gingerskull/Push-Pull-Encoder/docs/through-hole-buttons.md

# PP Stack assembly instructions · Through-hole buttons

These are the assembly instructions for the build with through-hole push buttons. Only the two buttons differ from the [SMD-button build](smd-buttons.md), which is 5 mm shorter. There's also a [printable PDF](../assembly-instructions-through-hole-buttons.pdf) (3 pages). Shop links for every part are in the [parts table](../README.md#parts-and-where-to-buy), and the board order settings are under [Ordering the PCB](../README.md#ordering-the-pcb).

[The parts](#the-parts) · [A · Bottom board](#a--bottom-board) · [B · Top board](#b--top-board) · [C · Assembly](#c--assembly)

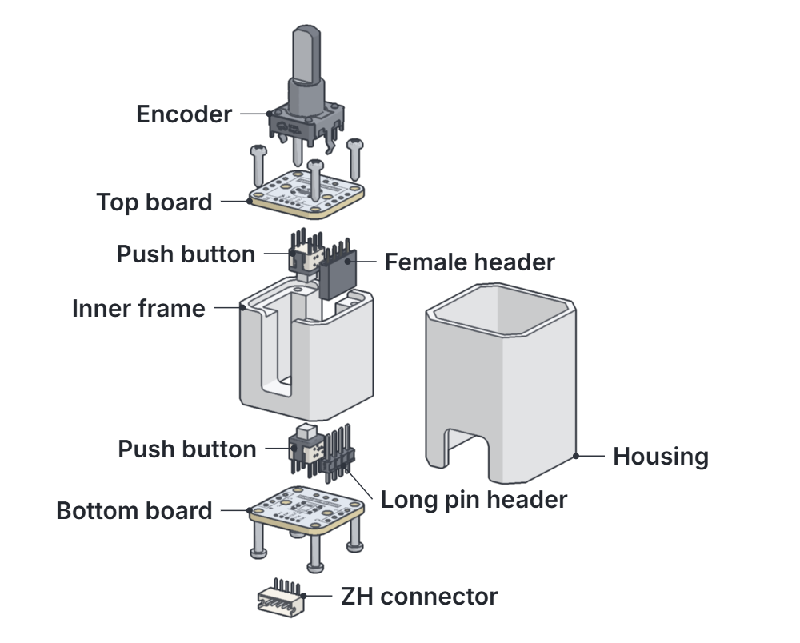
[picture p18: docs/img/through-hole/parts.png]
Exploded view of all parts
<picture><source media="(prefers-color-scheme: dark)" srcset="img/through-hole/parts-dark.png"></picture>

### The parts

| Qty | Part |
|--:|:---|
| 2 | PCB |
| 1 | EC12E rotary encoder |
| 2 | Push button, SAMZO 2010751102 |
| 1 | Female header, 4 pin, 2.54 mm |
| 1 | Long pin header, 4 pin, 21 mm |
| 1 | ZH1.5 connector, 5 pin |
| 8 | M2 self-tapping screw |
| 1 | Inner frame + housing, printed ([STEP](../CAD/printed/PP-Stack-frame-housing-through-hole-buttons.step)) |

You'll also need a soldering iron, flush cutters and a small screwdriver.

> [!IMPORTANT]
> The frame slides up and down inside the housing, so print both accurately. They need only a minimal gap: enough for smooth push and pull, not so much that the knob wobbles. Test-fit the frame in the housing before you assemble anything.

<br clear="right"><br>

---

## A · Bottom board

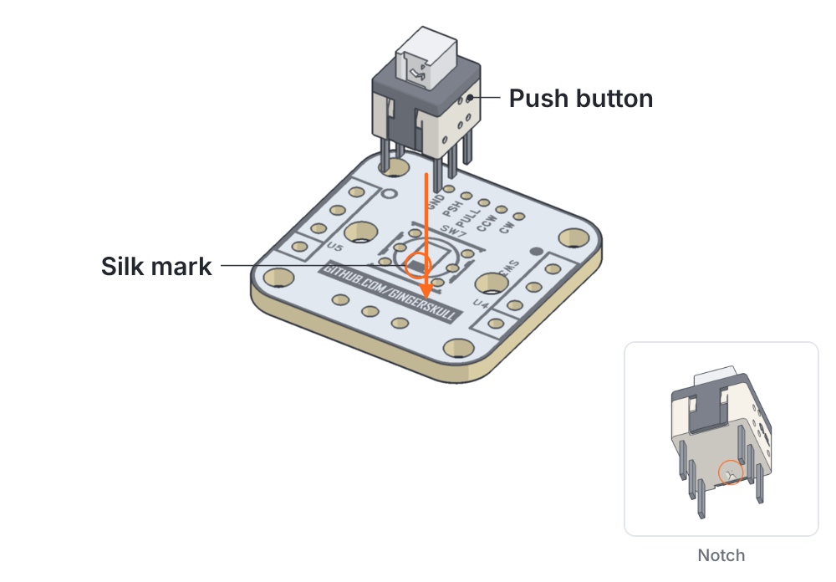
[picture p19: docs/img/through-hole/step-01.png]
Step 1
<picture><source media="(prefers-color-scheme: dark)" srcset="img/through-hole/step-01-dark.png"></picture>

### 1 · Push button

<kbd>Button side</kbd>

Fit SW7 with the notch on its underside **opposite** the filled mark in the SW7 outline.

> [!WARNING]
> Fitted the other way round, the switch works as normally closed.

> [!TIP]
> Trim the legs after soldering.

<br clear="right"><br>

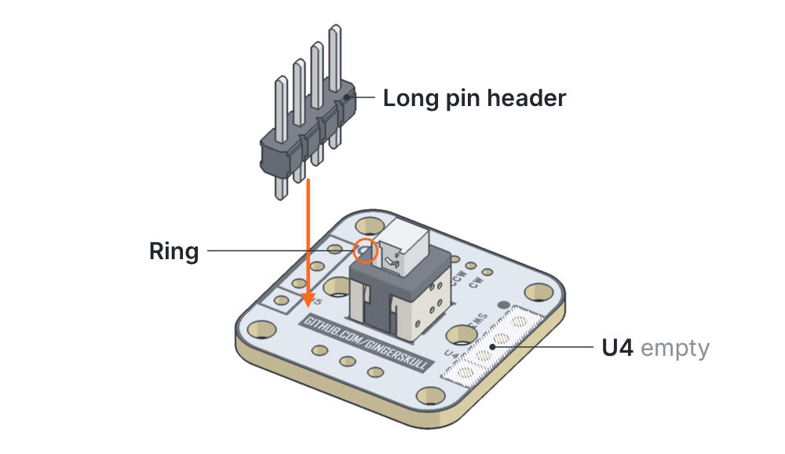
[picture p20: docs/img/through-hole/step-02.png]
Step 2
<picture><source media="(prefers-color-scheme: dark)" srcset="img/through-hole/step-02-dark.png"></picture>

### 2 · Long pin header

<kbd>U5</kbd>

Long pin header into **U5**, next to the ring. U4 stays empty on this board.

> [!TIP]
> Keep it square to the board, since these pins go into the top board's female header later.

<br clear="right"><br>

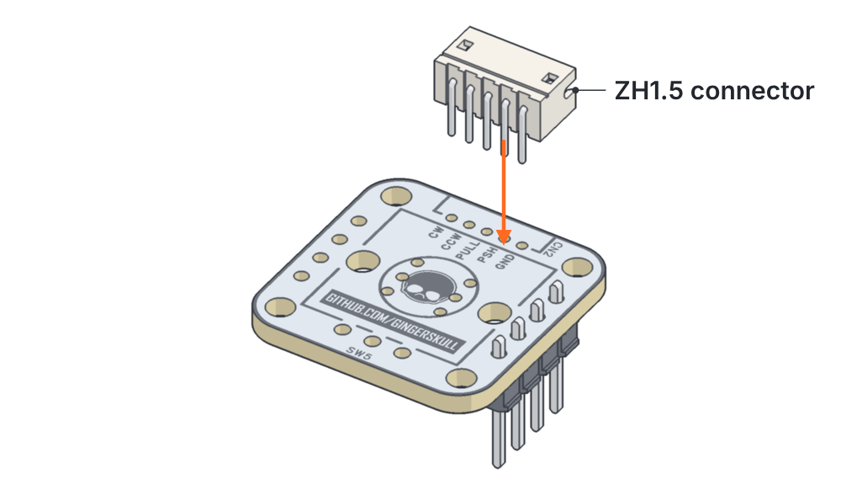
[picture p21: docs/img/through-hole/step-03.png]
Step 3
<picture><source media="(prefers-color-scheme: dark)" srcset="img/through-hole/step-03-dark.png"></picture>

### 3 · ZH connector

<kbd>Flip</kbd>

Flip the board. Fit CN2 with the opening facing the board edge.

<br clear="right"><br>

---

## B · Top board

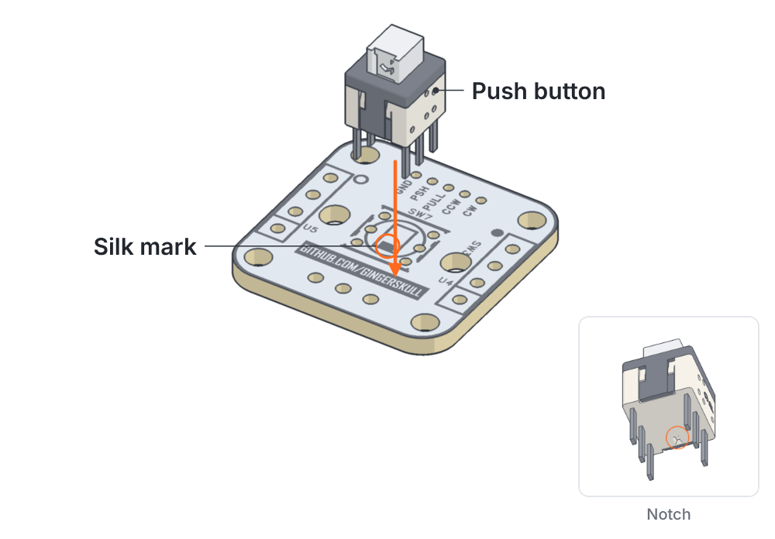
[picture p22: docs/img/through-hole/step-04.png]
Step 4
<picture><source media="(prefers-color-scheme: dark)" srcset="img/through-hole/step-04-dark.png"></picture>

### 4 · Push button

<kbd>Button side</kbd>

Same as step 1: notch opposite the silk mark.

> [!IMPORTANT]
> Trim the legs **flush**. The encoder sits right over them.

<br clear="right"><br>

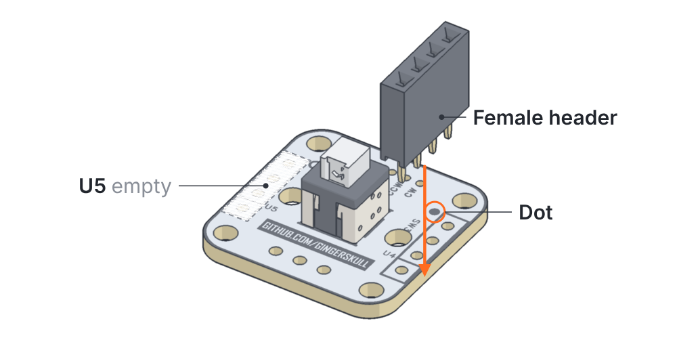
[picture p23: docs/img/through-hole/step-05.png]
Step 5
<picture><source media="(prefers-color-scheme: dark)" srcset="img/through-hole/step-05-dark.png"></picture>

### 5 · Female header

<kbd>U4</kbd>

Female header into **U4**, next to the dot. U5 stays empty on this board.

> [!NOTE]
> When the boards stack, the dot sits over the ring.

<br clear="right"><br>

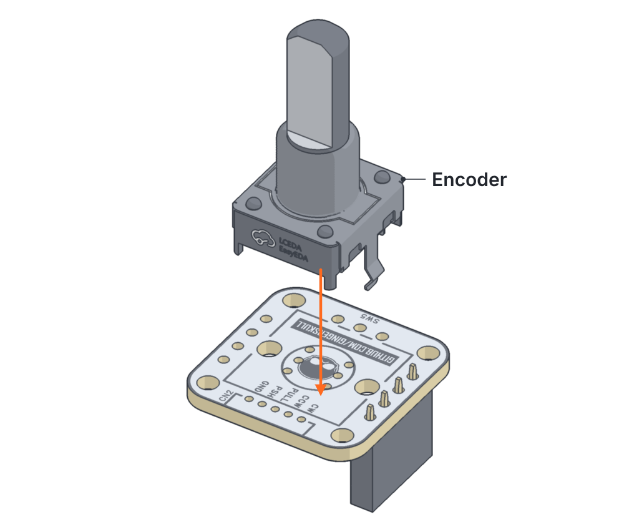
[picture p24: docs/img/through-hole/step-06.png]
Step 6
<picture><source media="(prefers-color-scheme: dark)" srcset="img/through-hole/step-06-dark.png"></picture>

### 6 · Encoder

<kbd>Flip</kbd>

Flip the board and fit the encoder.

> [!TIP]
> Solder the mounting tabs too. They carry the push and pull load.

<br clear="right"><br>

---

## C · Assembly

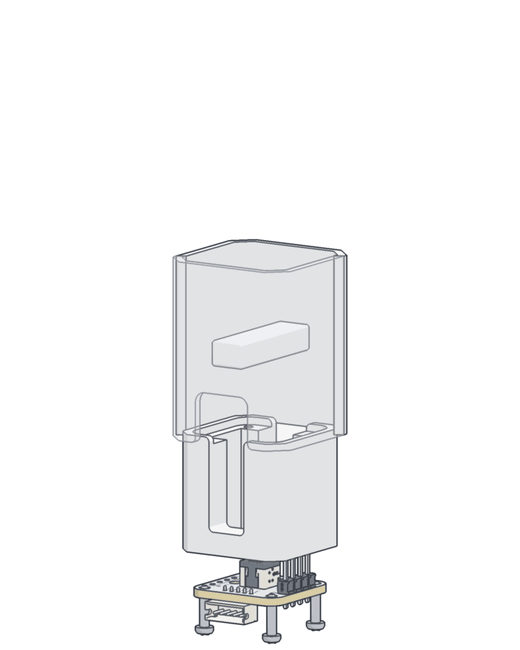
[picture p25: docs/img/through-hole/asm.gif]
Assembly sequence, steps 7 to 10
<p align="center"><picture><source media="(prefers-color-scheme: dark)" srcset="img/through-hole/asm-dark.gif"></picture></p>

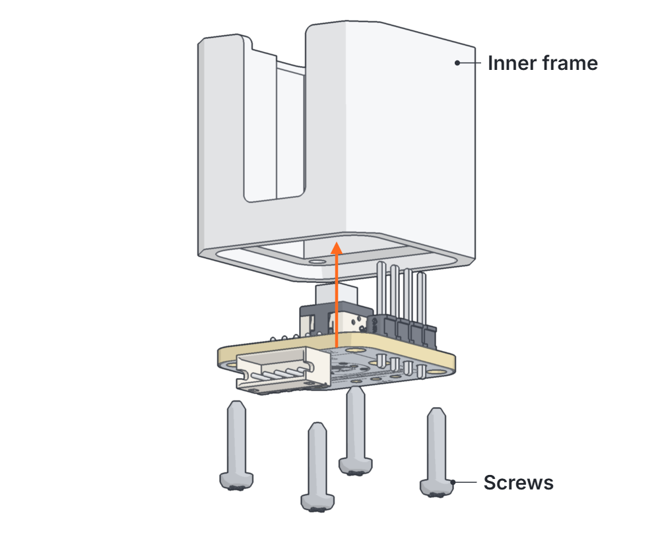
[picture p26: docs/img/through-hole/step-07.png]
Step 7
<picture><source media="(prefers-color-scheme: dark)" srcset="img/through-hole/step-07-dark.png"></picture>

### 7 · Bottom board onto the frame

<kbd>4 × M2</kbd>

Button side into the frame, then four self-tapping screws.

> [!CAUTION]
> Tighten them only until snug. They cut their own threads in the plastic.

<br clear="right"><br>

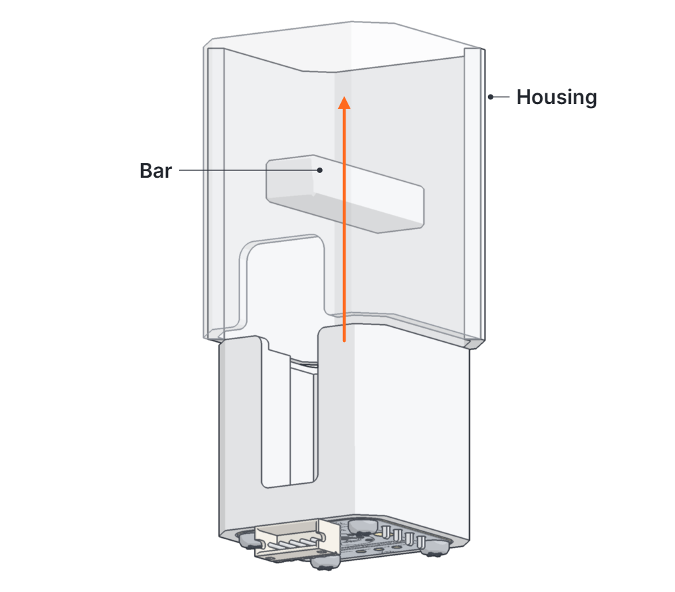
[picture p27: docs/img/through-hole/step-08.png]
Step 8
<picture><source media="(prefers-color-scheme: dark)" srcset="img/through-hole/step-08-dark.png"></picture>

### 8 · Into the housing

<kbd>From below</kbd>

Slide the frame up into the housing. The slots pass over the bar and the connector lines up with the cutout.

> [!NOTE]
> This puts the bar between the two push buttons.

<br clear="right"><br>

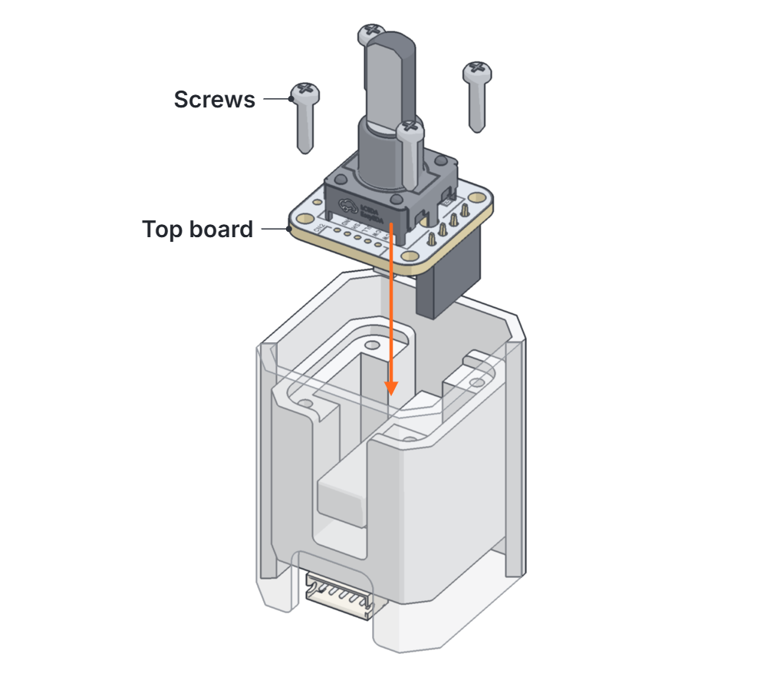
[picture p28: docs/img/through-hole/step-09.png]
Step 9
<picture><source media="(prefers-color-scheme: dark)" srcset="img/through-hole/step-09-dark.png"></picture>

### 9 · Top board

<kbd>4 × M2</kbd>

Lower the female header onto the long pins, dot over the ring, and screw the board down.

> [!TIP]
> Check the pins line up before you push down.

<br clear="right"><br>

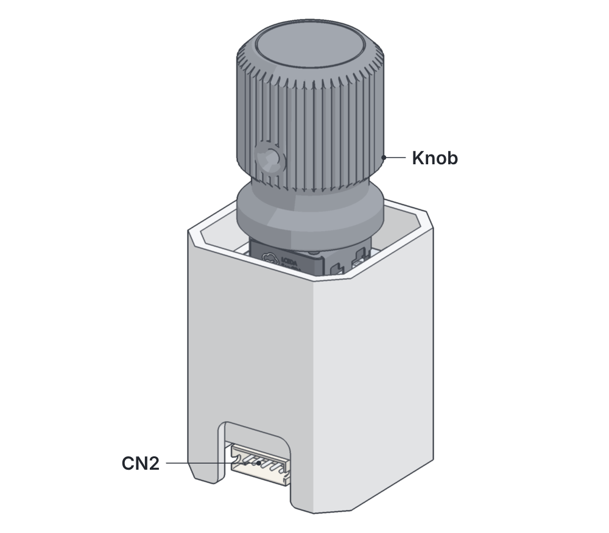
[picture p29: docs/img/through-hole/step-10.png]
Step 10
<picture><source media="(prefers-color-scheme: dark)" srcset="img/through-hole/step-10-dark.png"></picture>

### 10 · Done

Fit the knob and plug in the cable.

| CN2 pin | Signal |
|:---:|:---|
| 1 | GND |
| 2 | PULL |
| 3 | PUSH |
| 4 | CCW (A) |
| 5 | CW (B) |

<br clear="right"><br>

[← Back to the overview](../README.md)
