gingerskull/Push-Pull-Encoder/docs/img/flip-dark.gif

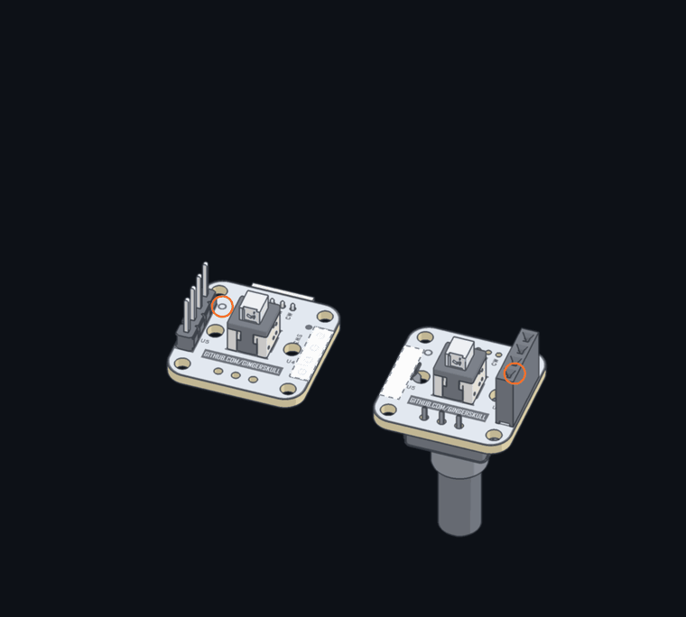
docs/img/flip-dark.gif
