gingerskull/Push-Pull-Encoder/docs/img/hero-dark.gif

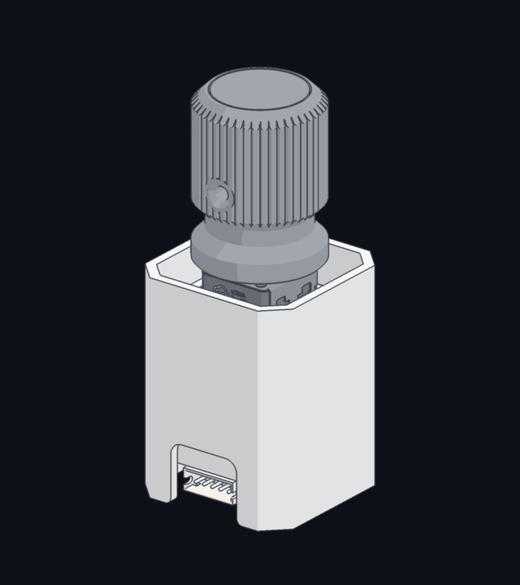
docs/img/hero-dark.gif
