gingerskull/Push-Pull-Encoder/docs/img/smd/asm-dark.gif

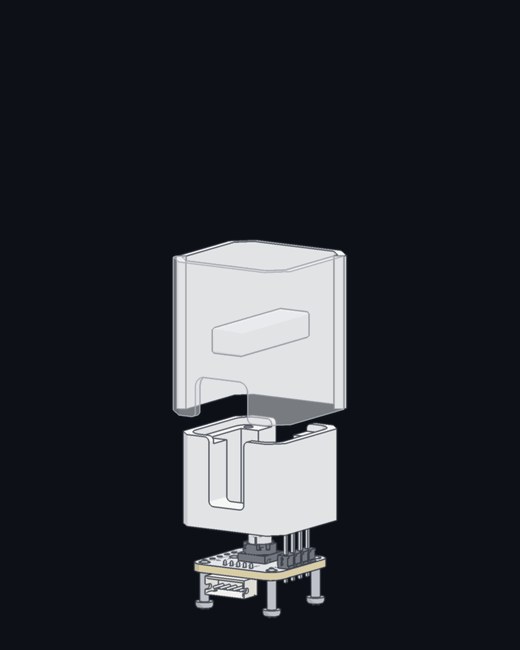
docs/img/smd/asm-dark.gif
