gingerskull/Push-Pull-Encoder/docs/img/smd/how-it-works-dark.png

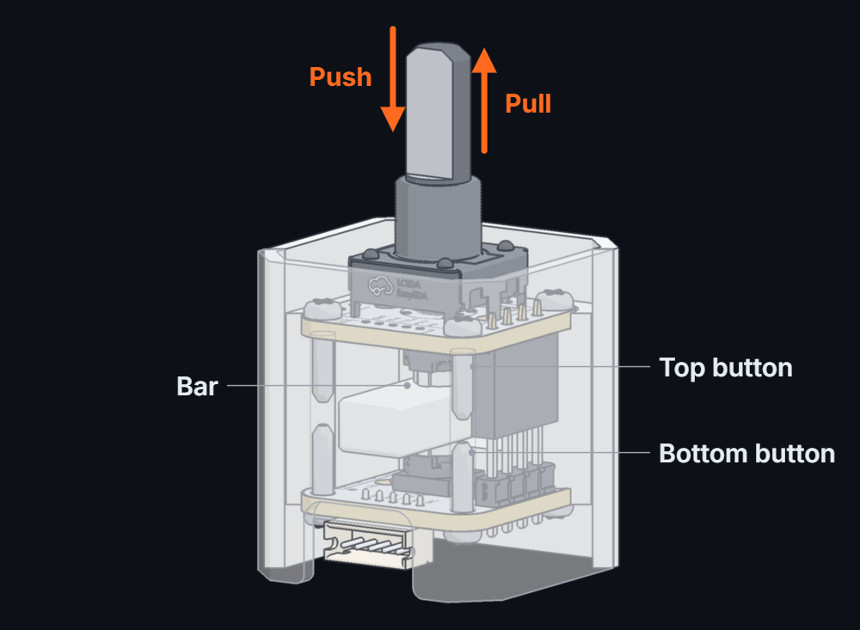
docs/img/smd/how-it-works-dark.png
