gingerskull/Push-Pull-Encoder/docs/img/smd/parts-dark.png

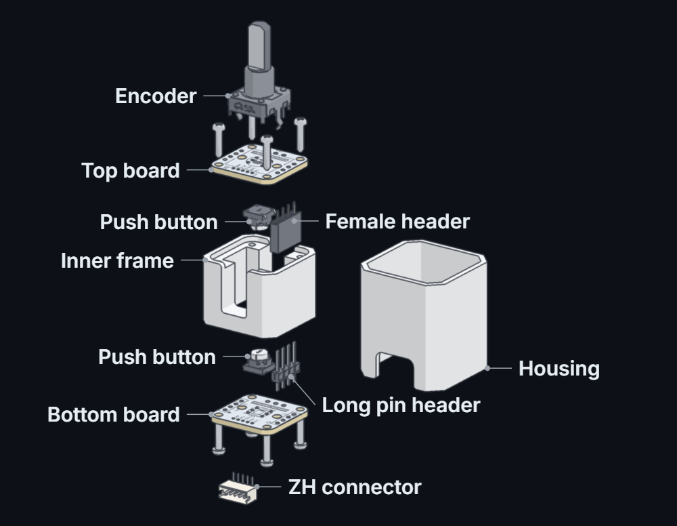
docs/img/smd/parts-dark.png
