gingerskull/Push-Pull-Encoder/CAD/assembly-example/PP-Stack-assembly-example-SMD-buttons.step

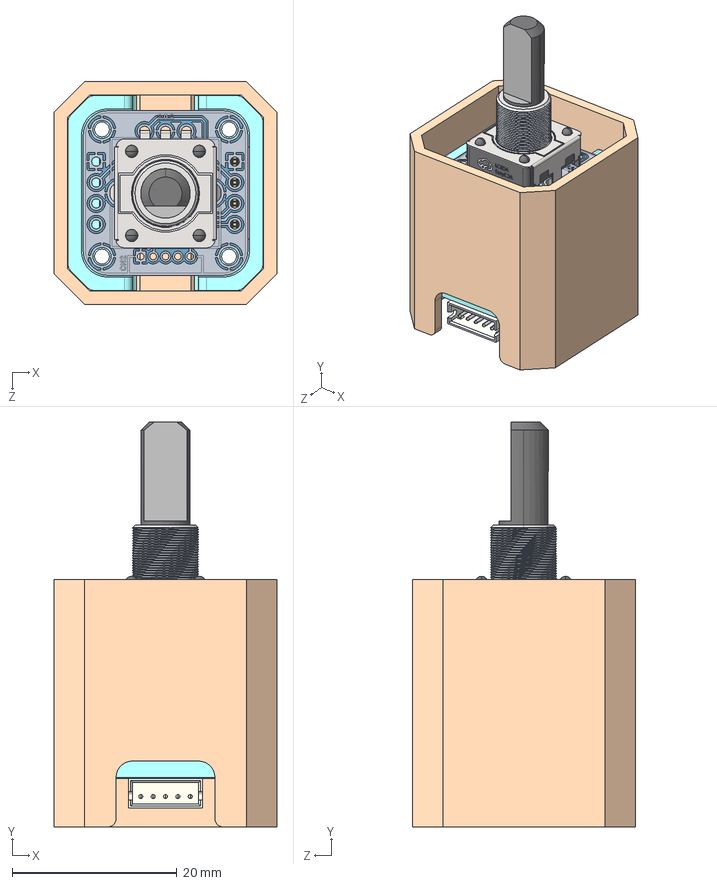
[picture p35: CAD file, 2026-11-04]
CAD/assembly-example/PP-Stack-assembly-example-SMD-buttons.step
27.0 x 49.1 x 27.0 mm
HDR-TH_4P-P2.54-V-F~HDR-TH_4P-P2.54-V-F~UFYu
KEY-SMD_4P-L6.1-W6.0-P4.50-LS7.4~KEY-SMD_4P-L6.1-W6.0-P4.50-LS7.4~UFYu x 2
SW-TH_EC12E2420801~SW-TH_EC12E2420801-L13.2-W12.4-H25.0-P2.5-LS14.0~UFYu
Board~UFYu x 2
TopCopper~UFYu x 2
BottomCopper~UFYu x 2
TopSilkscreen~UFYu x 2
BottomSilkscreen~UFYu x 2
HDR-TH_4P-P2.54-V-M~HDR-TH_4P-P2.54-M-LI-1X4P~UFYu
CONN-TH_5P-P1.50_HCTL_C-ZH1.5-5AW~CONN-TH_5P-P1.50_HCTL_C-ZH1.5-5AW~UFYu
PP Stack V2 - Housing Complete 15mm
