gingerskull/Push-Pull-Encoder/CAD/printed/PP-Stack-frame-housing-SMD-buttons.step

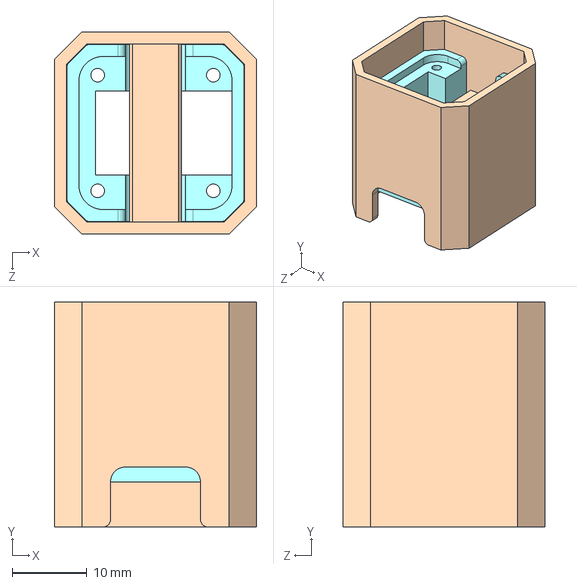
[picture p37: CAD file, 2026-11-04]
CAD/printed/PP-Stack-frame-housing-SMD-buttons.step
27.0 x 30.0 x 27.0 mm
