gingerskull/Push-Pull-Encoder/CAD/printed/PP-Stack-frame-housing-through-hole-buttons.step

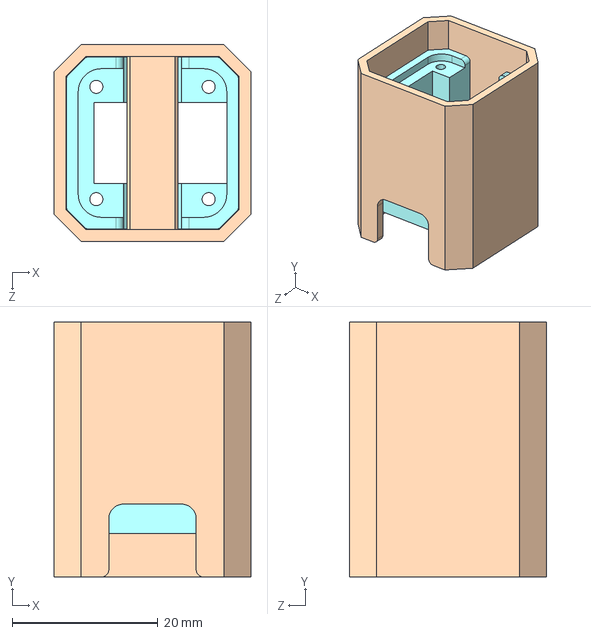
[picture p38: CAD file, 2026-11-04]
CAD/printed/PP-Stack-frame-housing-through-hole-buttons.step
27.0 x 35.0 x 27.0 mm
