gingerskull/Push-Pull-Encoder/CAD/printed/PP-Stack-knob-v3.step

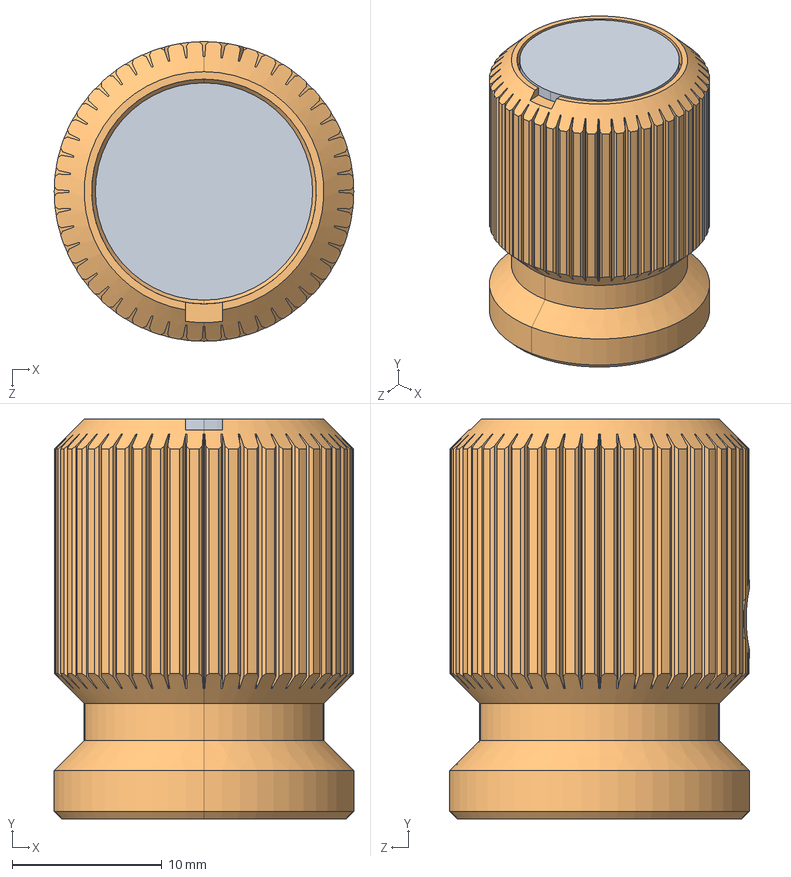
[picture p39: CAD file, 2026-11-04]
CAD/printed/PP-Stack-knob-v3.step
20.0 x 26.7 x 20.0 mm
