gingerskull/Push-Pull-Encoder/assembly-instructions-SMD-buttons.pdf

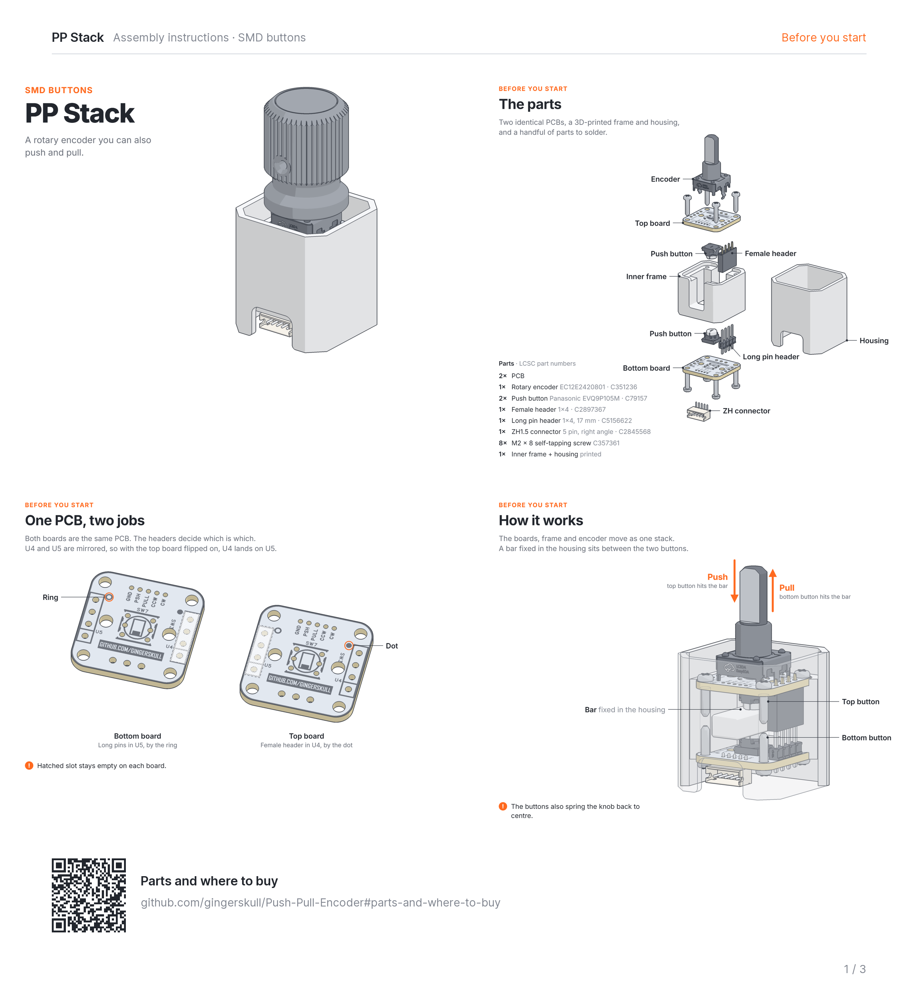
[picture p48: page 1]
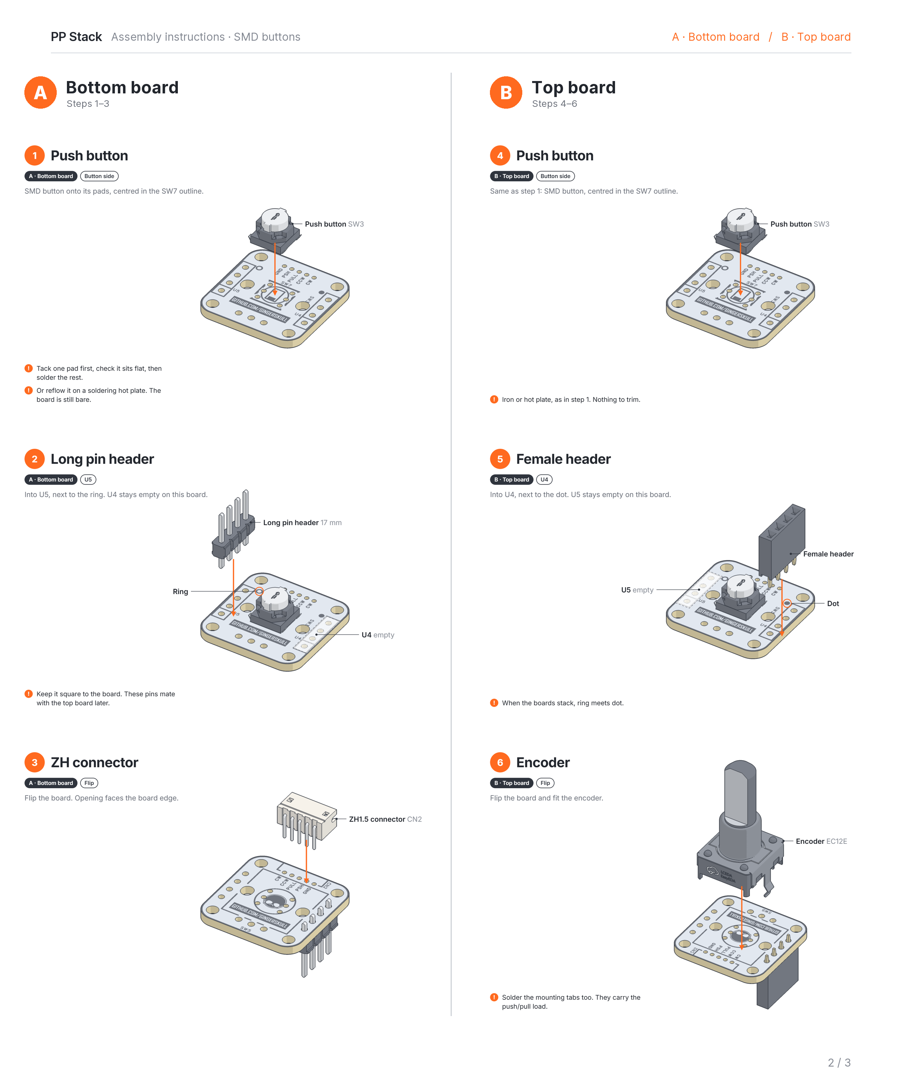
[picture p49: page 2]
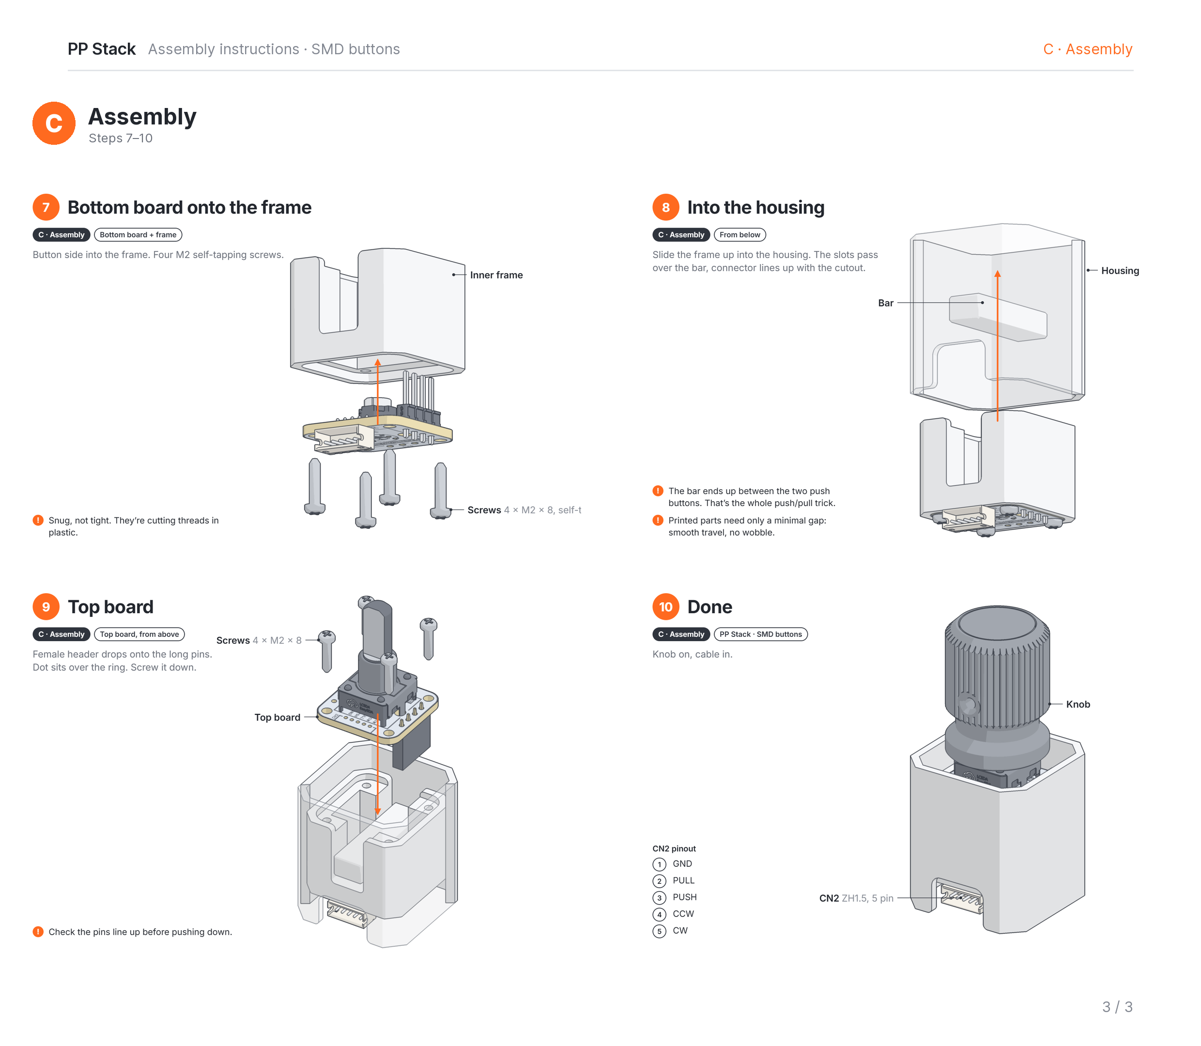
[picture p50: page 3]
