gingerskull/Push-Pull-Encoder/assembly-instructions-through-hole-buttons.pdf

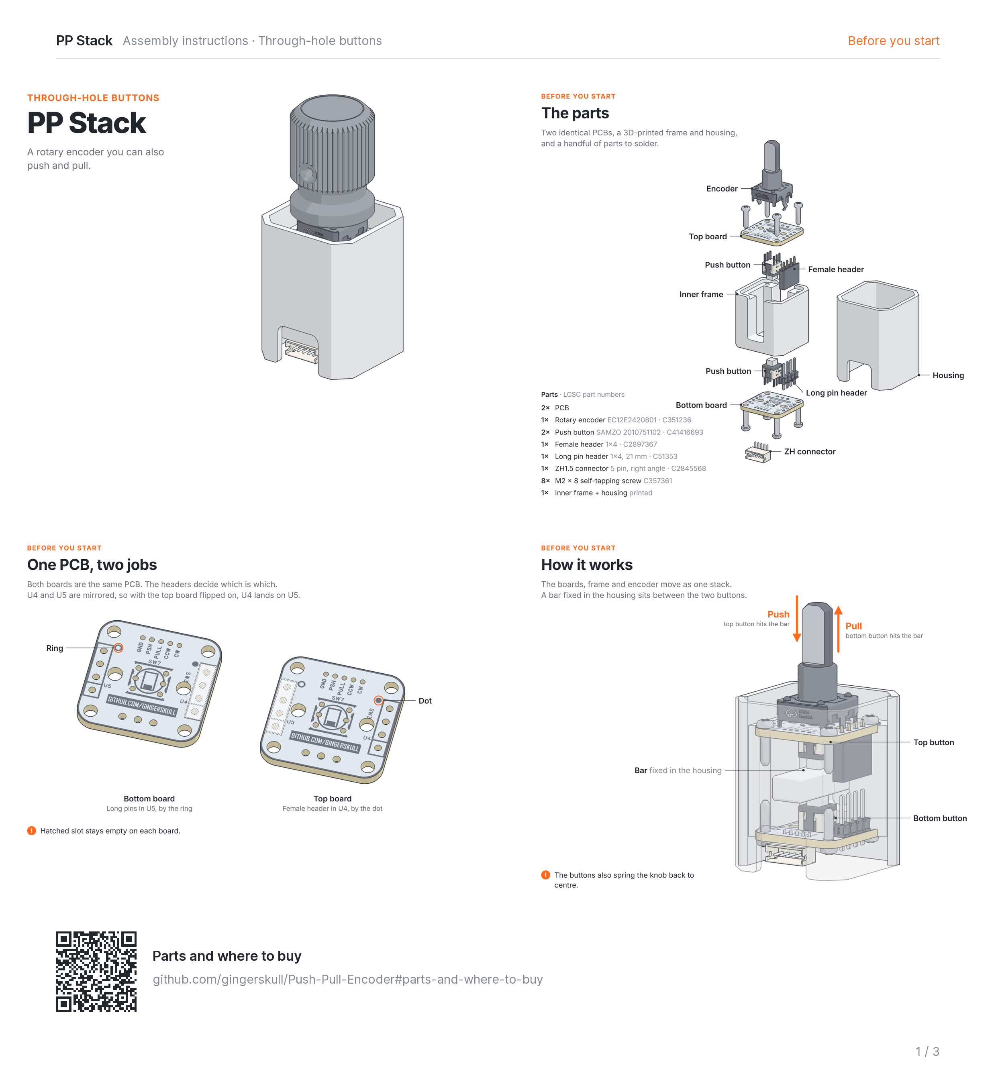
[picture p51: page 1]
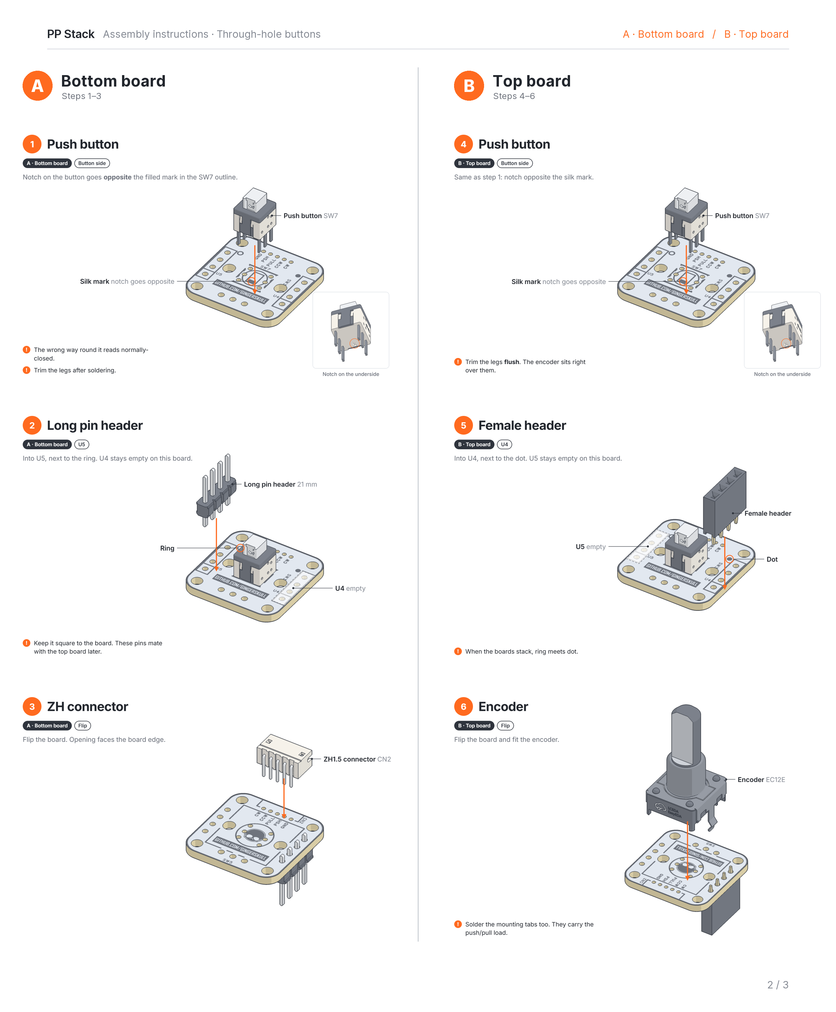
[picture p52: page 2]
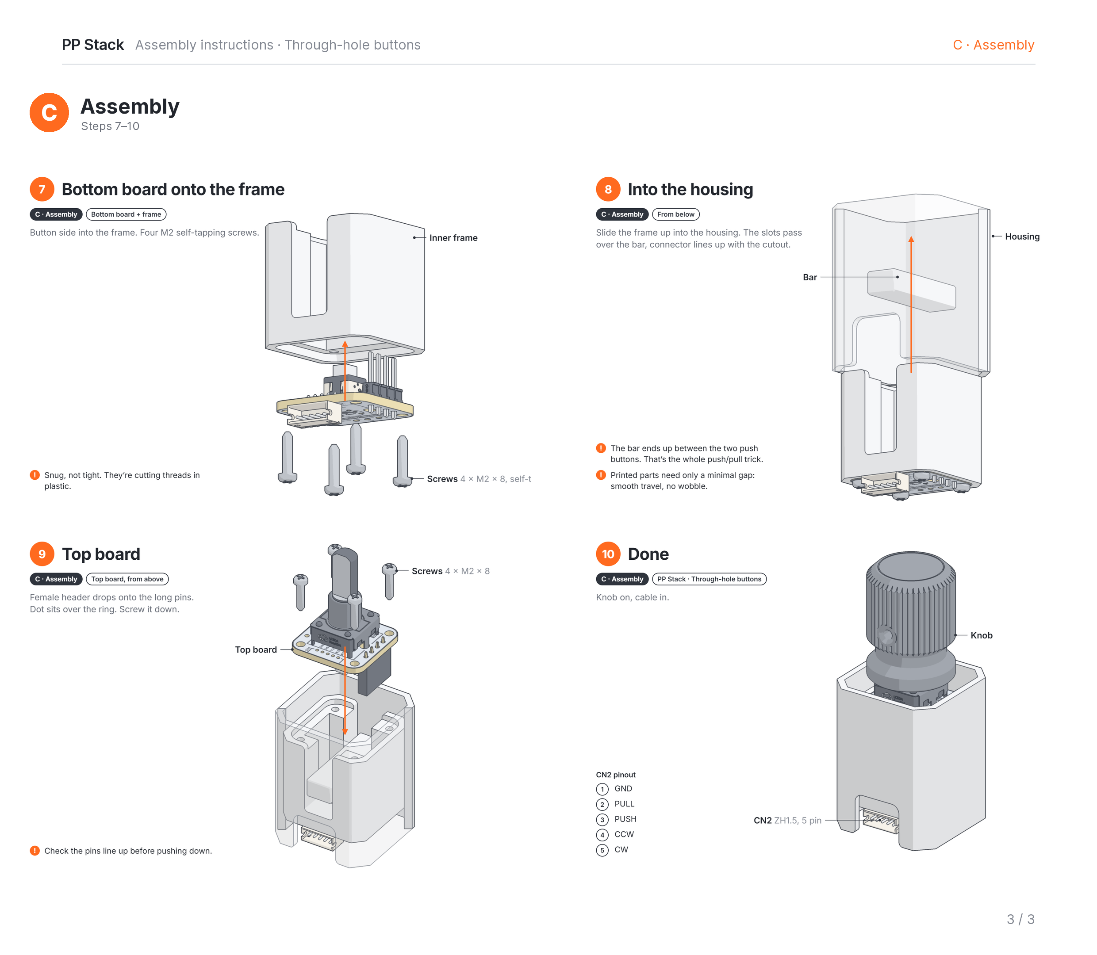
[picture p53: page 3]
