gingerskull/Push-Pull-Encoder/docs/img/build-through-hole-dark.png

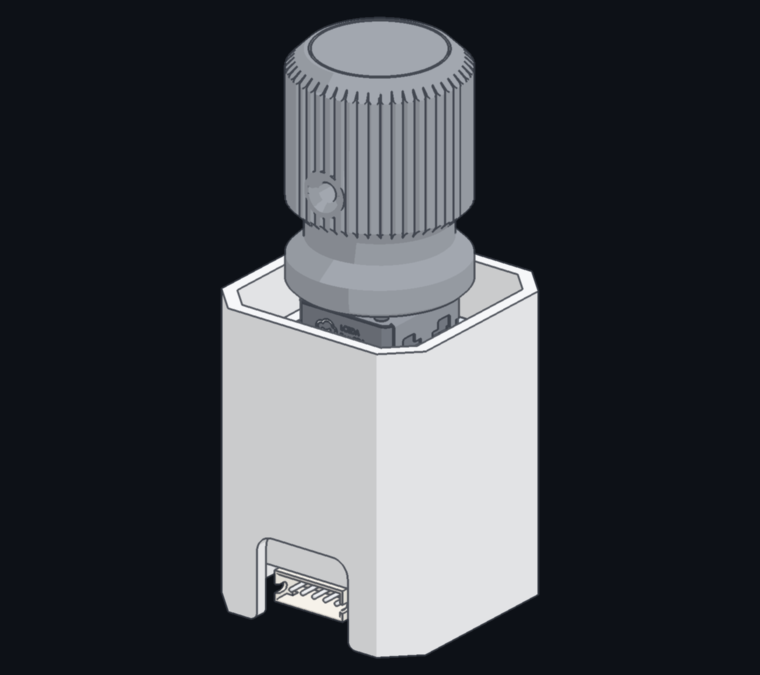
docs/img/build-through-hole-dark.png
