gingerskull/Push-Pull-Encoder/docs/img/smd/step-01-dark.png

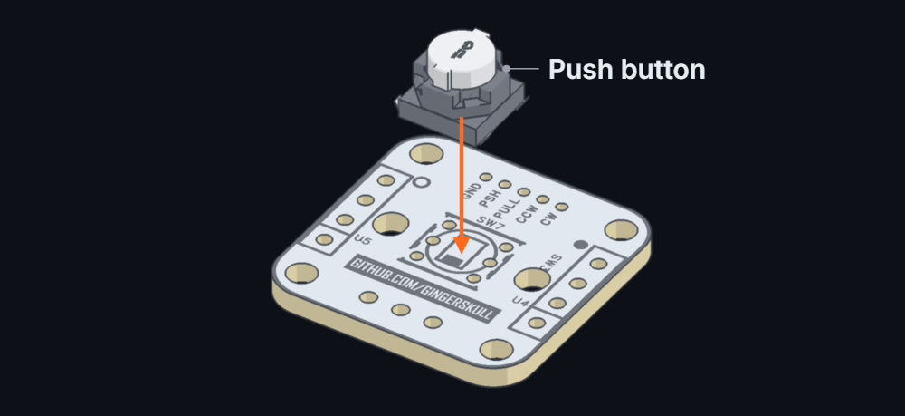
docs/img/smd/step-01-dark.png
