gingerskull/Push-Pull-Encoder/docs/img/smd/step-02-dark.png

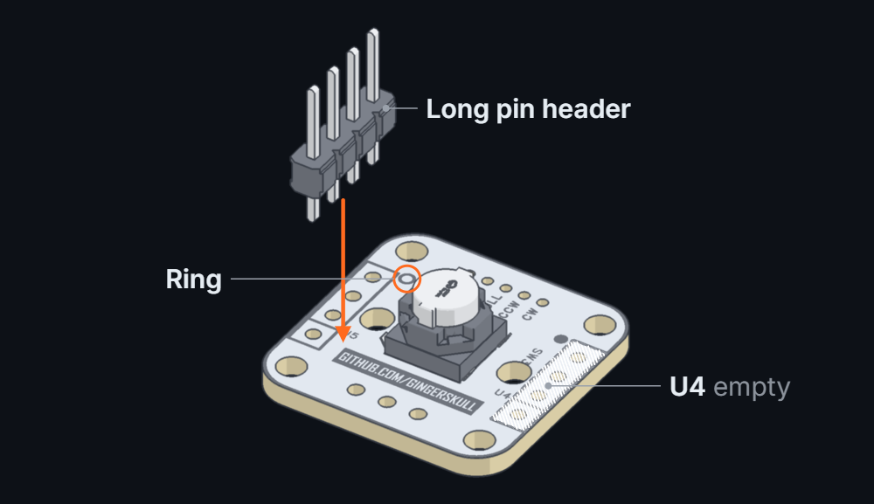
docs/img/smd/step-02-dark.png
