gingerskull/Push-Pull-Encoder/docs/img/smd/step-03-dark.png

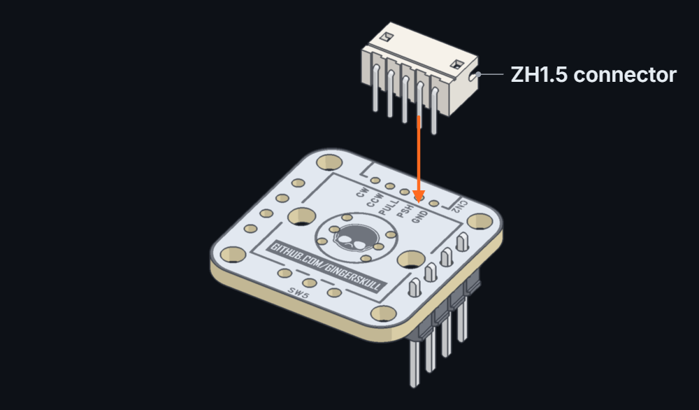
docs/img/smd/step-03-dark.png
