gingerskull/Push-Pull-Encoder/docs/img/smd/step-05-dark.png

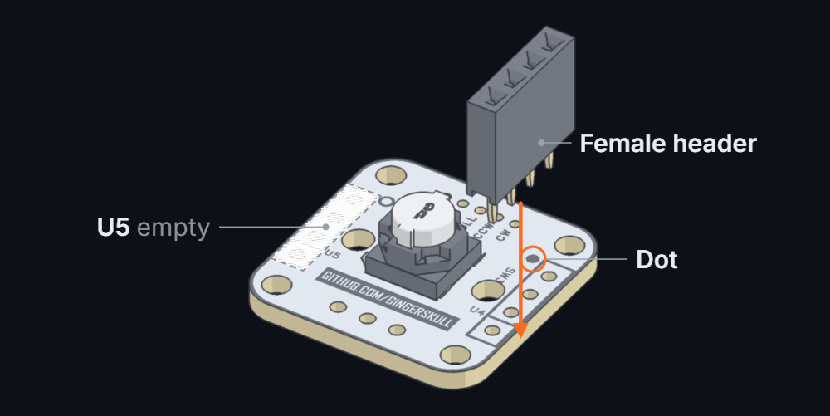
docs/img/smd/step-05-dark.png
