gingerskull/Push-Pull-Encoder/docs/img/smd/step-06-dark.png

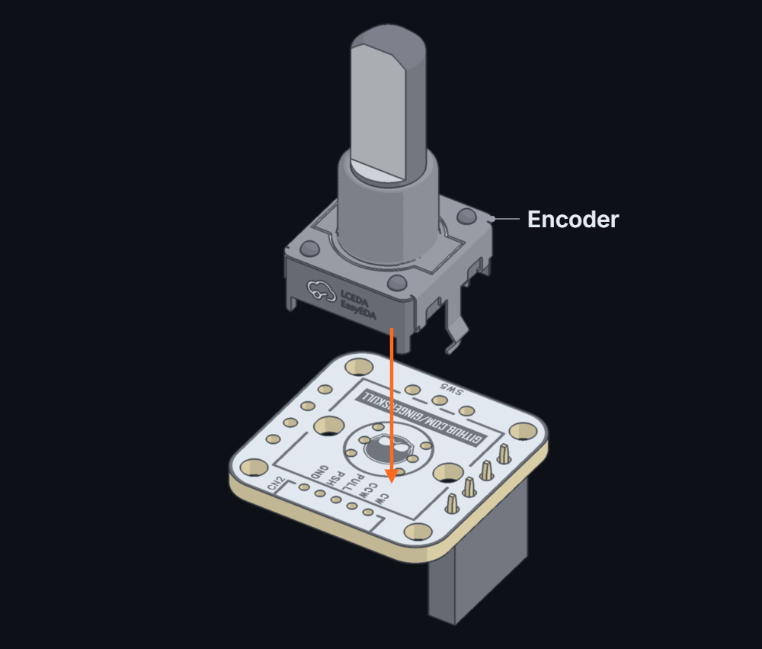
docs/img/smd/step-06-dark.png
