gingerskull/Push-Pull-Encoder/docs/img/smd/step-07-dark.png

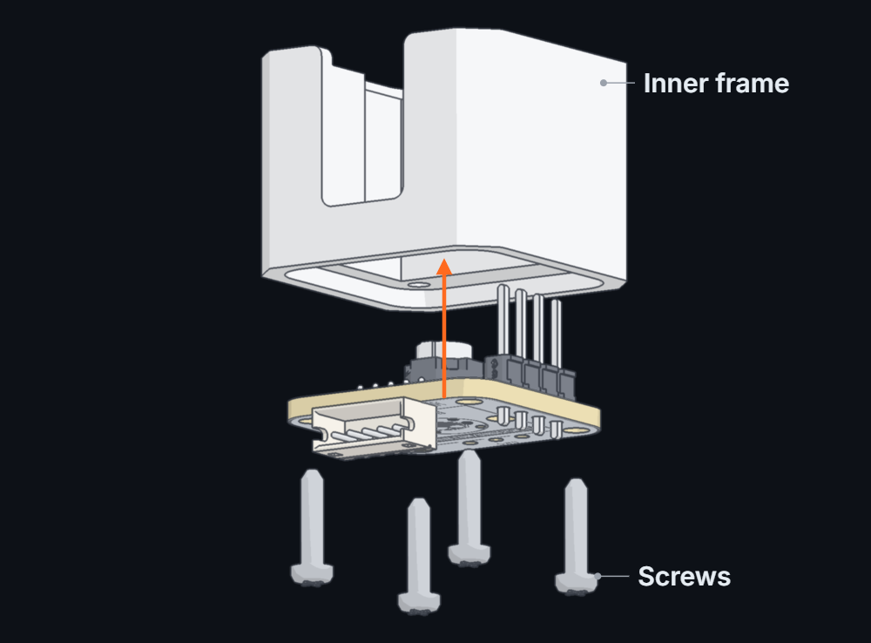
docs/img/smd/step-07-dark.png
