gingerskull/Push-Pull-Encoder/docs/img/smd/step-08-dark.png

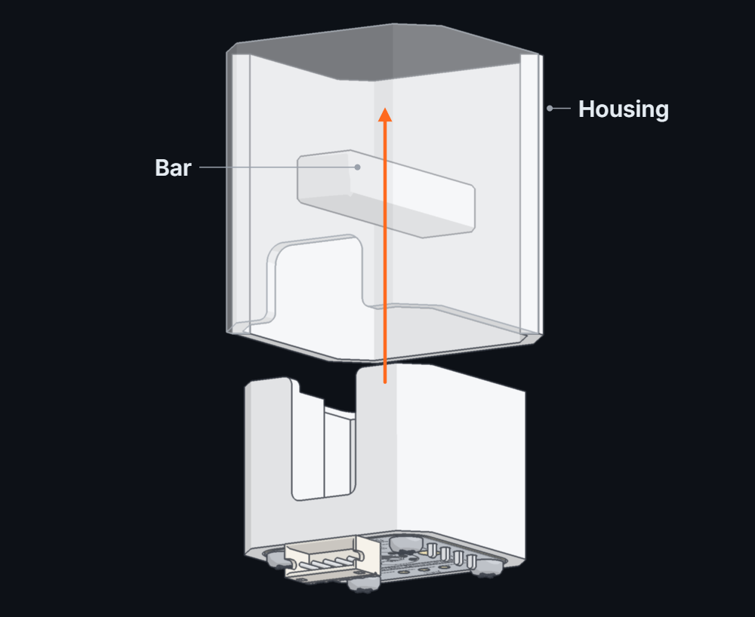
docs/img/smd/step-08-dark.png
