gingerskull/Push-Pull-Encoder/docs/img/smd/step-09-dark.png

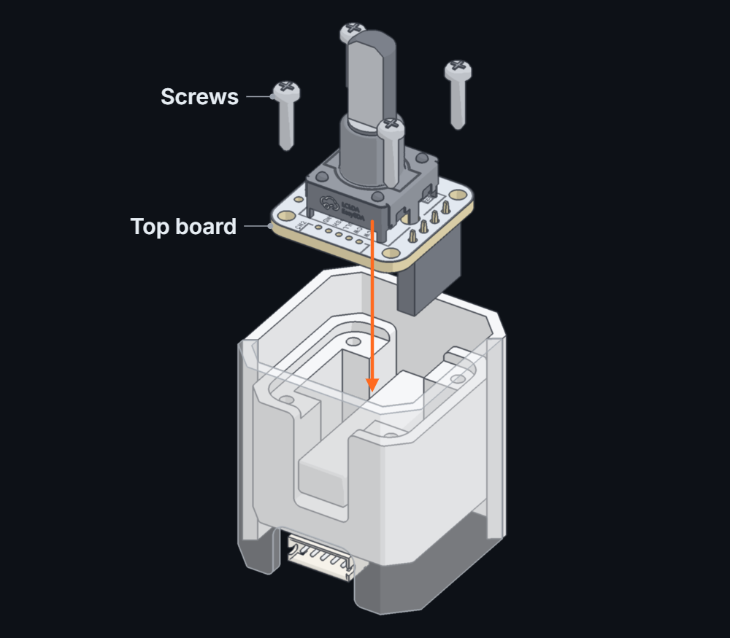
docs/img/smd/step-09-dark.png
