gingerskull/Push-Pull-Encoder/docs/img/through-hole/step-01-dark.png

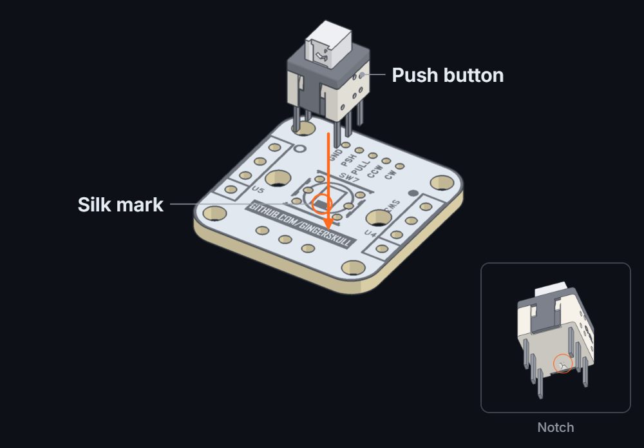
docs/img/through-hole/step-01-dark.png
