gingerskull/Push-Pull-Encoder/docs/img/through-hole/step-07-dark.png

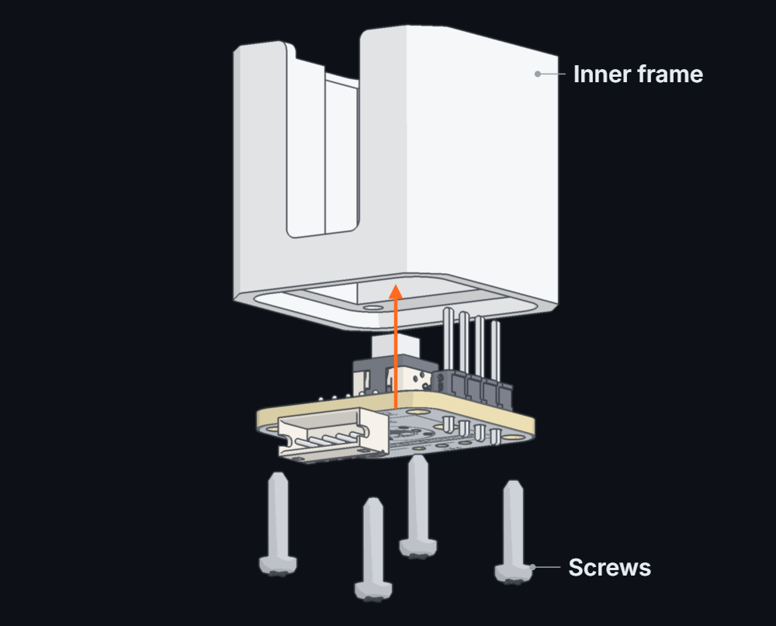
docs/img/through-hole/step-07-dark.png
