gingerskull/Push-Pull-Encoder/docs/img/through-hole/step-09-dark.png

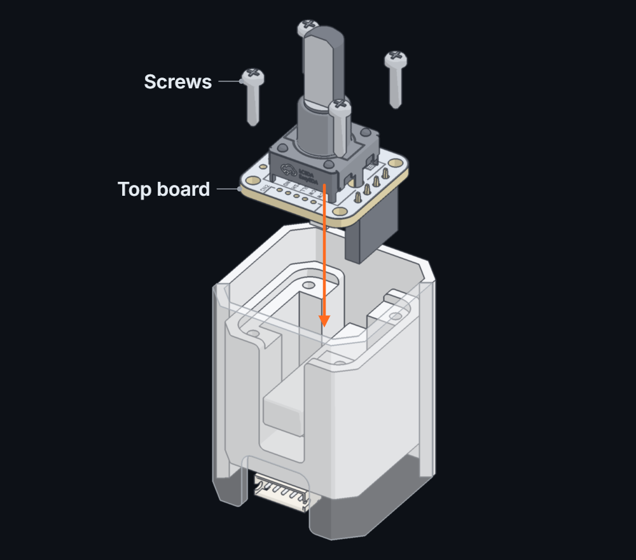
docs/img/through-hole/step-09-dark.png
