gingerskull/Push-Pull-Encoder/CAD/pcb/PP-Stack-PCB-v2-schematic.pdf

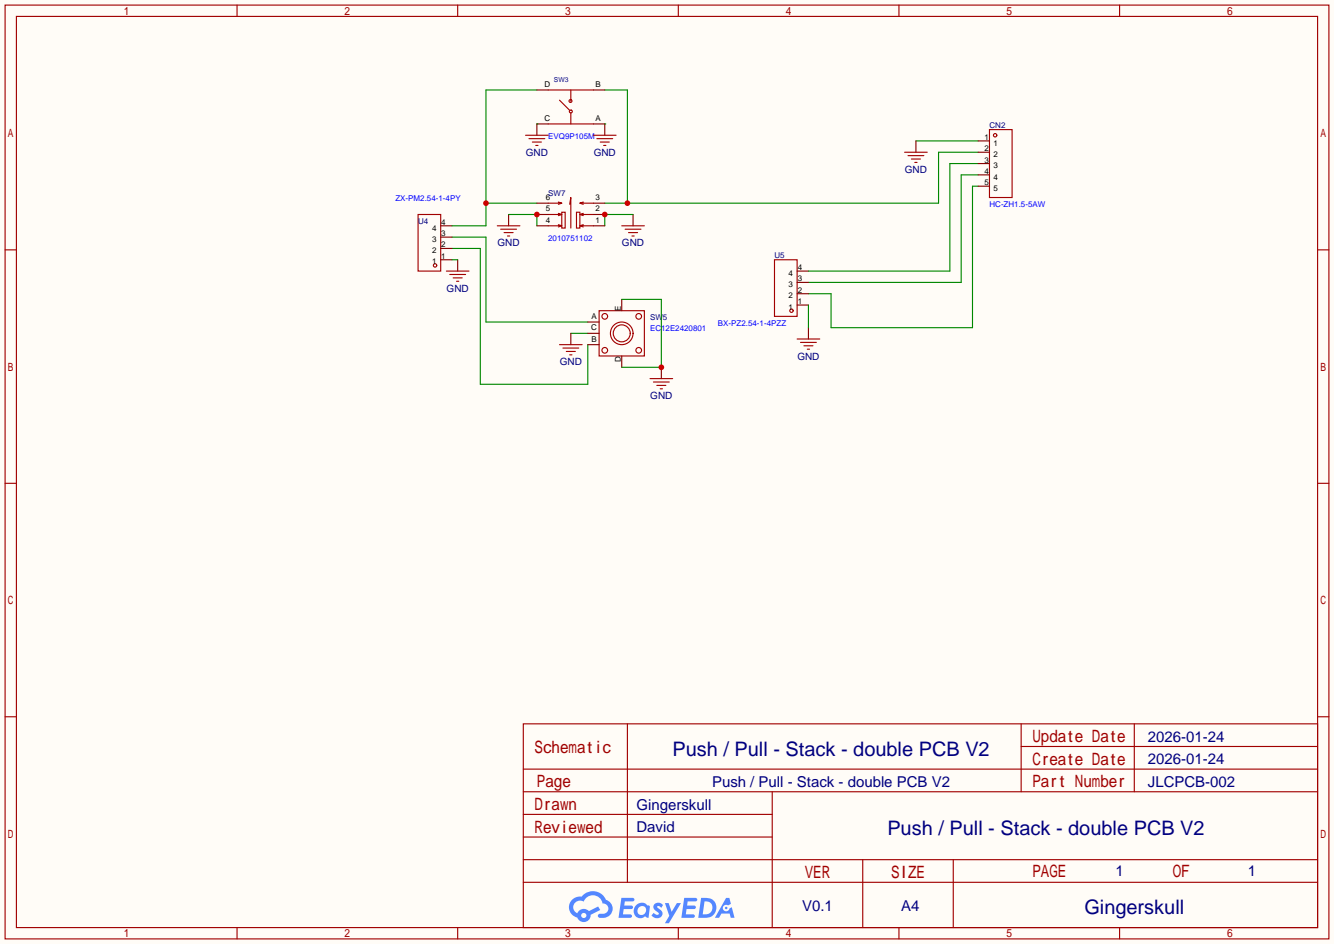
[picture p66: page 1]

2026-01-24 Push / Pull - Stack - double PCB V2
Push / Pull - Stack - double PCB V2
