gingerskull/Push-Pull-Encoder/(commit log)

2026-11-04 docs: add the 20 mm assembly guide, printable PDF and CAD files
    README with the parts, the one-PCB-used-twice idea and steps for both boards and the assembly, three animations, a printable PDF, and example 15 mm and 20 mm assemblies plus the knob as STEP files.
    [Assembly Example - PP Stack - 15.STEP, Assembly Example - PP Stack - 20.STEP, Encoder Knob PP V3.STEP]
2026-11-04 docs: make the see-through housing easier to read
2026-11-04 docs: add the 15 mm SMD version, split the guide per version and add shop links
2026-11-04 docs: call the guides assembly instructions, add the hot plate option and the printed-parts fit note
2026-11-04 docs: name the builds after their push buttons (through-hole / SMD)
2026-11-04 docs: add the PCB files and printed parts, organise CAD/ and explain how to order the PCB
    [PP-Stack-assembly-SMD-buttons.step, PP-Stack-assembly-through-hole-buttons.step, PP-Stack-frame-housing-SMD-buttons.step, PP-Stack-frame-housing-through-hole-buttons.step, PP-Stack-knob-v3.step]
2026-11-04 docs: M2 x 8 screws, rename the PDFs and the example assemblies, note the ZH and button variants
    [PP-Stack-assembly-example-SMD-buttons.step, PP-Stack-assembly-example-through-hole-buttons.step]
2026-11-04 docs: show the two builds as full-width cards with assembly instructions buttons
2026-11-04 docs: drop the PCB order settings table
2026-11-04 docs: add an assembly instructions table with links to the pages and PDFs
